MrNoberto/pulseira-seguranca-industrial-esp32/docs/imagens/oled-procurando.png

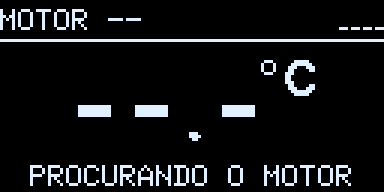
docs/imagens/oled-procurando.png
