MrNoberto/pulseira-seguranca-industrial-esp32/docs/imagens/oled-sem-sinal.png

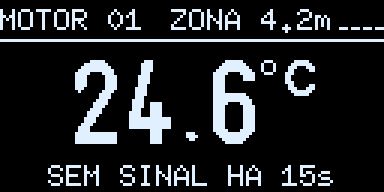
docs/imagens/oled-sem-sinal.png
