MrNoberto/pulseira-seguranca-industrial-esp32/docs/imagens/oled-vibracao.png

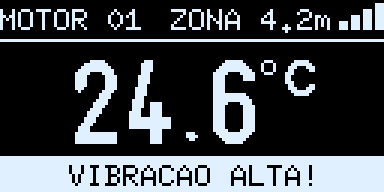
docs/imagens/oled-vibracao.png
