MrNoberto/pulseira-seguranca-industrial-esp32/docs/imagens/tft-erro-dht.png

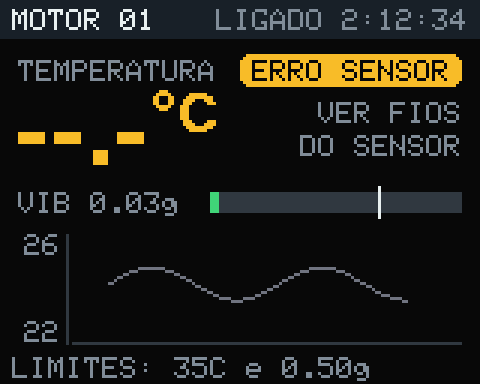
docs/imagens/tft-erro-dht.png
