MrNoberto/pulseira-seguranca-industrial-esp32/(commit log)

2026-10-30 Pulseira de segurança industrial com ESP32 (Ideathon Sebrae + ArcelorMittal)
    Três firmwares que conversam por ESP-NOW: a pulseira do trabalhador (OLED,
    buzzer e LEDs), o nó da máquina (DHT11, MPU6050 e TFT) e o farol que marca a
    zona de perigo. Inclui a documentação técnica completa (hardware e ligações,
    protocolo, algoritmos, verificação e guia de uso) e as ferramentas em Python
    usadas para simular a lógica, ajustar a zona e desenhar as telas.
    [esp1_pulseira.ino, esp2_motor.ino, esp3_zona.ino]
2026-10-31 Usa os nomes SentryBand (pulseira) e Sentinela (máquina)
    Título, introdução, tabelas, diagramas e títulos de seção da
    documentação passam a usar os nomes do projeto. Nos firmwares, só o
    comentário do cabeçalho mudou: o código compilado é o mesmo.
